zhangrun-source/mcu-realtime-clock-course-design/(list of files, drawings)

Other design files:
Proteus_c/实时钟_全功能.pdsprj
