zhangrun-source/mcu-realtime-clock-course-design/(commit log)

2026-07-20 Add multi-function real-time clock course project
    [实时钟_全功能.pdsprj]
2026-07-20 Update and rename 答辩说辞.md to 问答.md
